RubenHerRui/TFG/TFG-RemoteCAN/docs/tfgitic-v7.1/tfe.tex

\documentclass{tfgitic}[2024/07/01]
% Recordeu que teniu les opcions de classe que es diuen
% a la documentació. Per exemple:
% \documentclass[english,master]{tfgitic}[2024/07/01]

% Aqui carregueu packages complementaris que necessiteu
%\usepackage{}

% Indica quines bd bibliografiques usarem
\addbibresource{tfe.bib}

\title{}
% Si voleu subtitol descomenteu
%\subtitle{}

% L'autor del treball. Admet gènere (vegeu 9.2 del manual) fent \author[f]{}
\author{}

% La direcció. Un treball ordinari te un o excepcionalment dos directors.
% admet gènerer i número (vegeu 9.2 del manual)
\advisor{}

% Si el treball es fa sota un conveni de pràctiques (modalitat empresa)
% llavors el director (advisor) és la persona de la empresa que
% dirigeix el treball i, a més, hi ha un professor que fa de tutor (counselor).
% En aquest cas també es consigna l'empresa (company)
% \counselor admet gènere (vegeu 9.2 del manual)
%
% \counselor{}
% \company{}

% Els àmbits temàtics en que es classifica el treball. Pregunteu al
% director.
\topics{}

% Si defenseu el projecte en una ciutat diferent de Manresa,
% descomenteu
% \location{}

% Si l'escola no és UPC Manresa, descomenteu
% \school{}

% Si el grau no és Sistemes TIC, descomenteu
% \degree{}
% \ects{}

% Si voleu dedicatòria descomenteu
%\dedication{}

% Si voleu agraïments descomenteu
%\begin{acknowledgments}
%\end{acknowledgments}

\begin{resum}
\end{resum}

\begin{abstract}
\end{abstract}

\begin{document}

% Si feu servir apèndixs, descomenteu
%\part{Memòria}

\chapter{Introducció}
\chapter{Antecedents}

% Aqui van els capitols especifics del treball

\chapter{Estudi econòmic}
\chapter{Impacte ambiental i social}
\chapter{Conclusions}
\chapter{Treball futur}

\printbibliography

% Si feu servir apèndixs, descomenteu
% (també la  \part del principi del document)
%\appendix
%\part{Apèndixs}
%\chapter{Un apèndix}

\end{document}

%%% Local Variables:
%%% mode: latex
%%% TeX-master: t
%%% LaTeX-biblatex-use-Biber: t
%%% End:
