RubenHerRui/TFG/TFG-RemoteCAN/shield/Esp32shield/Esp32shield.kicad_pcb

## KiCad design TFG-RemoteCAN/shield/Esp32shield/Esp32shield.kicad_pcb (2025-07-04)

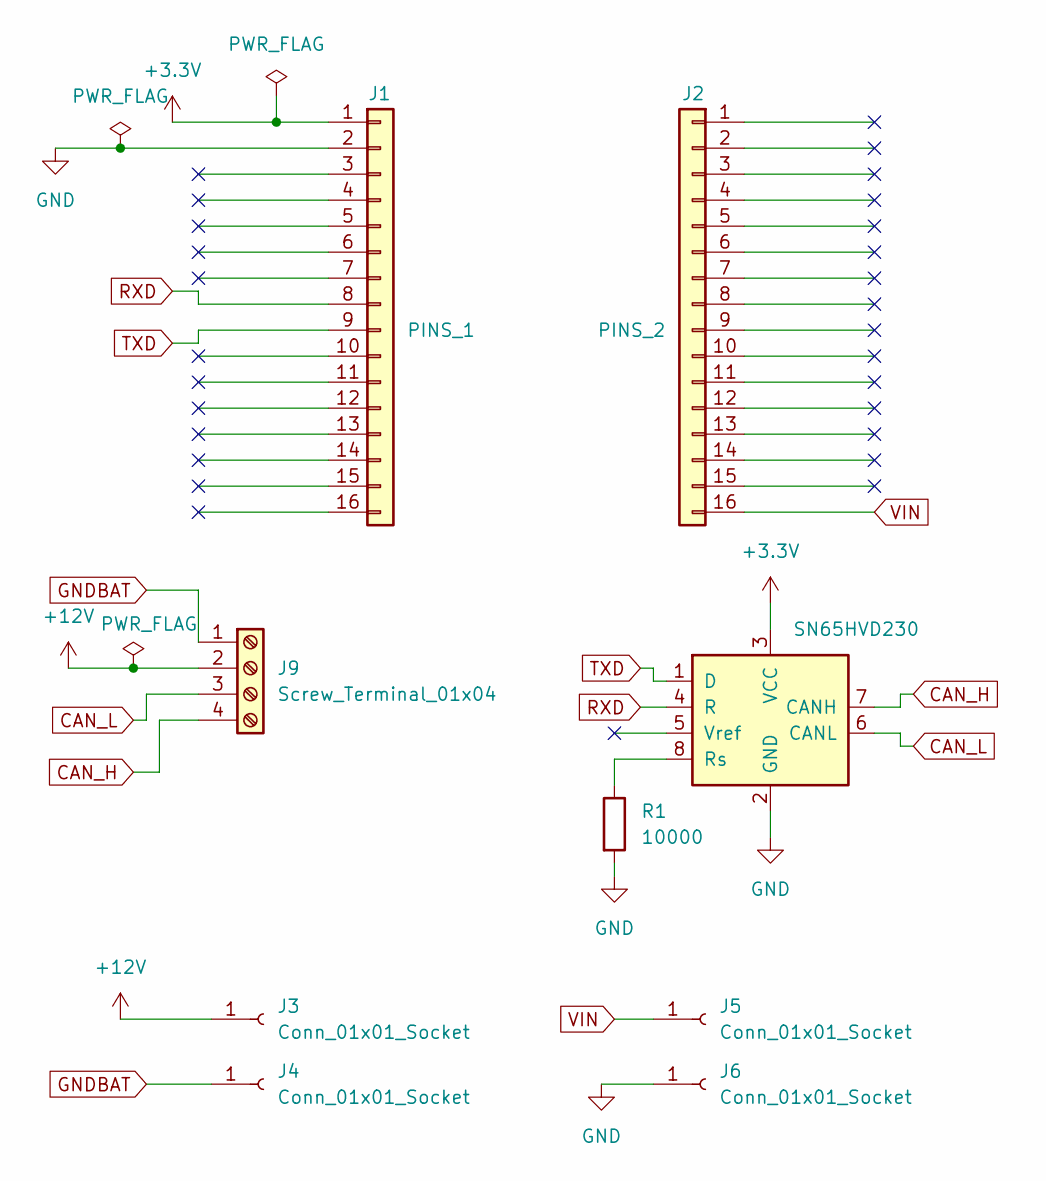
[picture p24: schematic Esp32shield.kicad_sch]

Parts:
J1: PINS_1; PinSocket_1x16_P2.54mm_Vertical
J2: PINS_2; PinSocket_1x16_P2.54mm_Vertical
J3, J4, J5, J6: Conn_01x01_Socket; MountingHole_2.2mm_M2_DIN965_Pad
J9: Screw_Terminal_01x04; TerminalBlock_Phoenix_MPT-0,5-4-2.54_1x04_P2.54mm_Horizontal
R1: 10000; R_Axial_DIN0207_L6.3mm_D2.5mm_P7.62mm_Horizontal
U1: SN65HVD230; SOIC-8_3.9x4.9mm_P1.27mm

Connections:
+3.3V: J1.1, U1.3 (VCC)
+12V: J3.1, J9.2
CAN_H: J9.4, U1.7 (CANH)
CAN_L: J9.3, U1.6 (CANL)
GND: J1.2, J6.1, R1.2, U1.2 (GND)
GNDBAT: J4.1, J9.1
unnamed: R1.1, U1.8 (Rs)
RXD: J1.8, U1.4 (R)
TXD: J1.9, U1.1 (D)
VIN: J2.16, J5.1

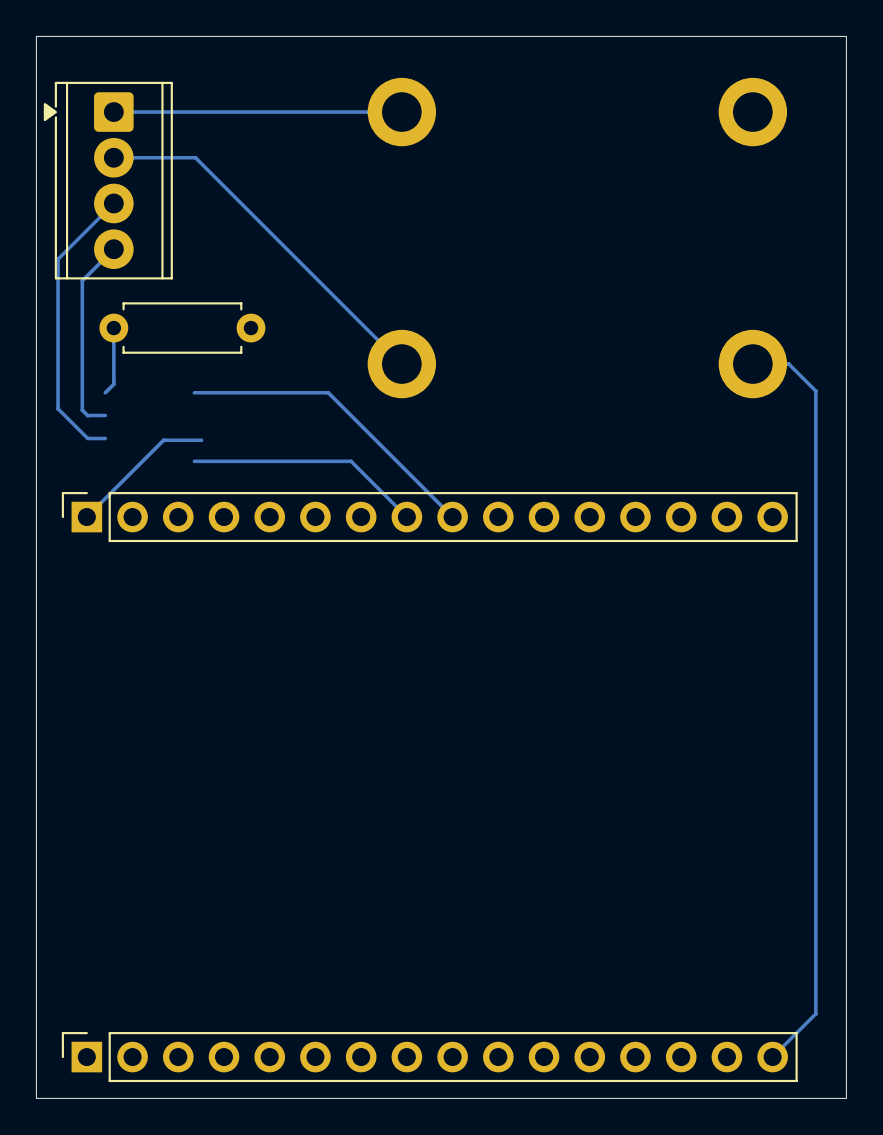
[picture p25: board Esp32shield.kicad_pcb from above]

Board: 2 copper layers, 45.0 x 59.0 mm, 9 parts (1 on the bottom side), 10 nets.
