RubenHerRui/TFG/TFG-RemoteCAN/firmware/ESP32-RemoteCAN/src/Sniffer_Gestor.c

#include <stdio.h>        
#include <stdint.h>     
#include "driver/twai.h"   
#include "driver/uart.h"

#define SEPARATOR ","
#define TERMINATOR "\n"

void print_hex(uint32_t value) {
    printf("%02lX", value);  
}

void print_sniffing(twai_message_t message){
    print_hex(message.identifier);
    printf(SEPARATOR);
    print_hex(message.rtr);  
    printf(SEPARATOR);  
    print_hex(message.extd);  
    printf(SEPARATOR);  
    for (uint8_t i = 0; i < message.data_length_code; i++) {
        print_hex(message.data[i]);
    }
    printf(TERMINATOR);
}
