RubenHerRui/TFG/(commit log)

2025-06-03 Versió 1.0
    [Esp32shield.kicad_pcb, Esp32shield.kicad_sch, pyvenv.cfg]
2025-07-04 Versió 1.1
    [Esp32shield-B_Cu.gbr, Esp32shield-B_Mask.gbr, Esp32shield-B_Paste.gbr, Esp32shield-B_Silkscreen.gbr, Esp32shield-Edge_Cuts.gbr, Esp32shield-F_Cu.gbr, Esp32shield-F_Mask.gbr, Esp32shield-F_Paste.gbr]
